nnh12/ROV-Motherboard-2022/Individual Schematics/Daughterboard_Slots_Sch.pdf

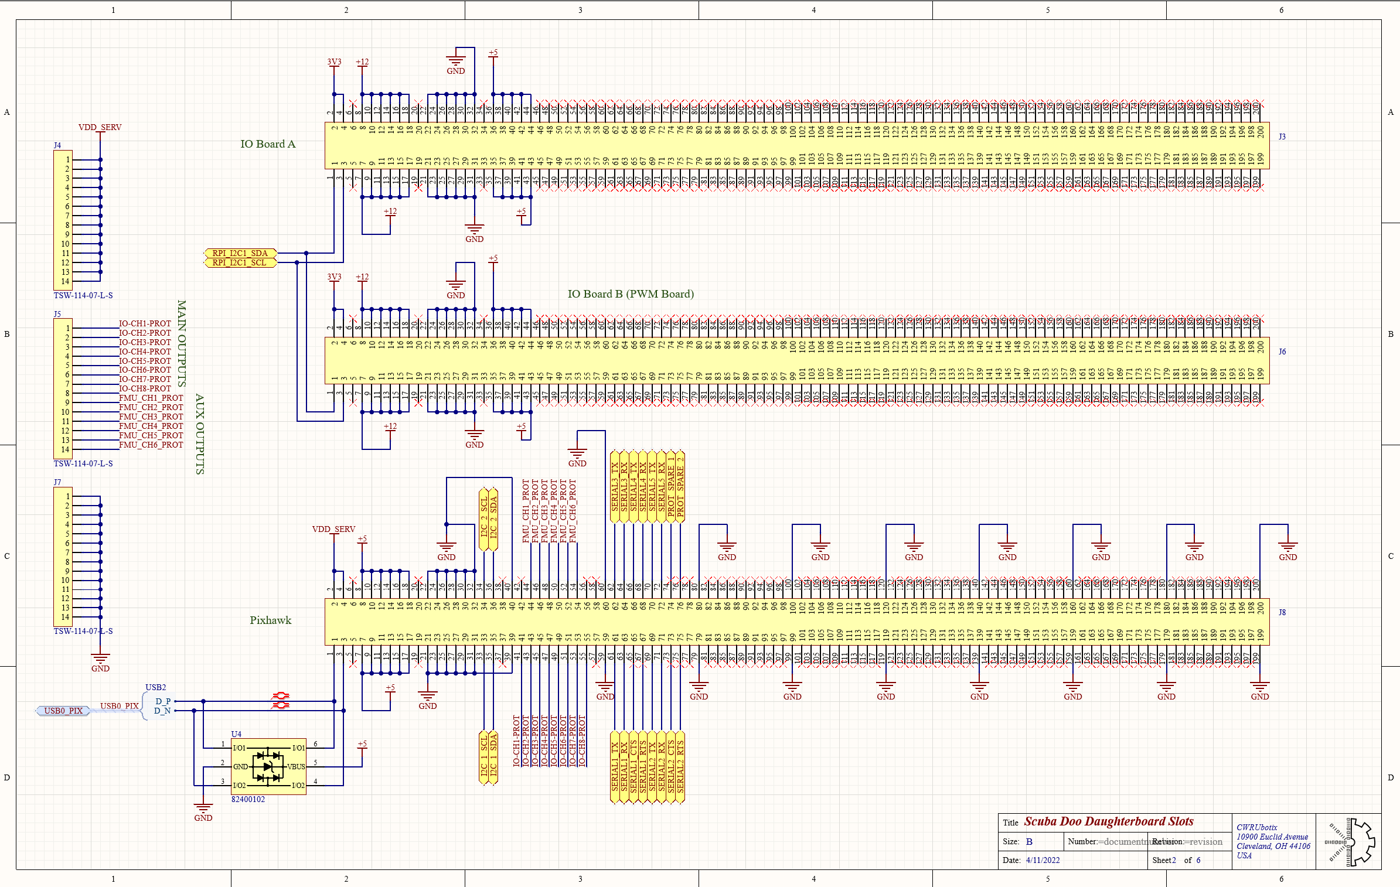
[picture p4: page 1]
