nnh12/ROV-Motherboard-2022/Individual Schematics/Ethernet.pdf

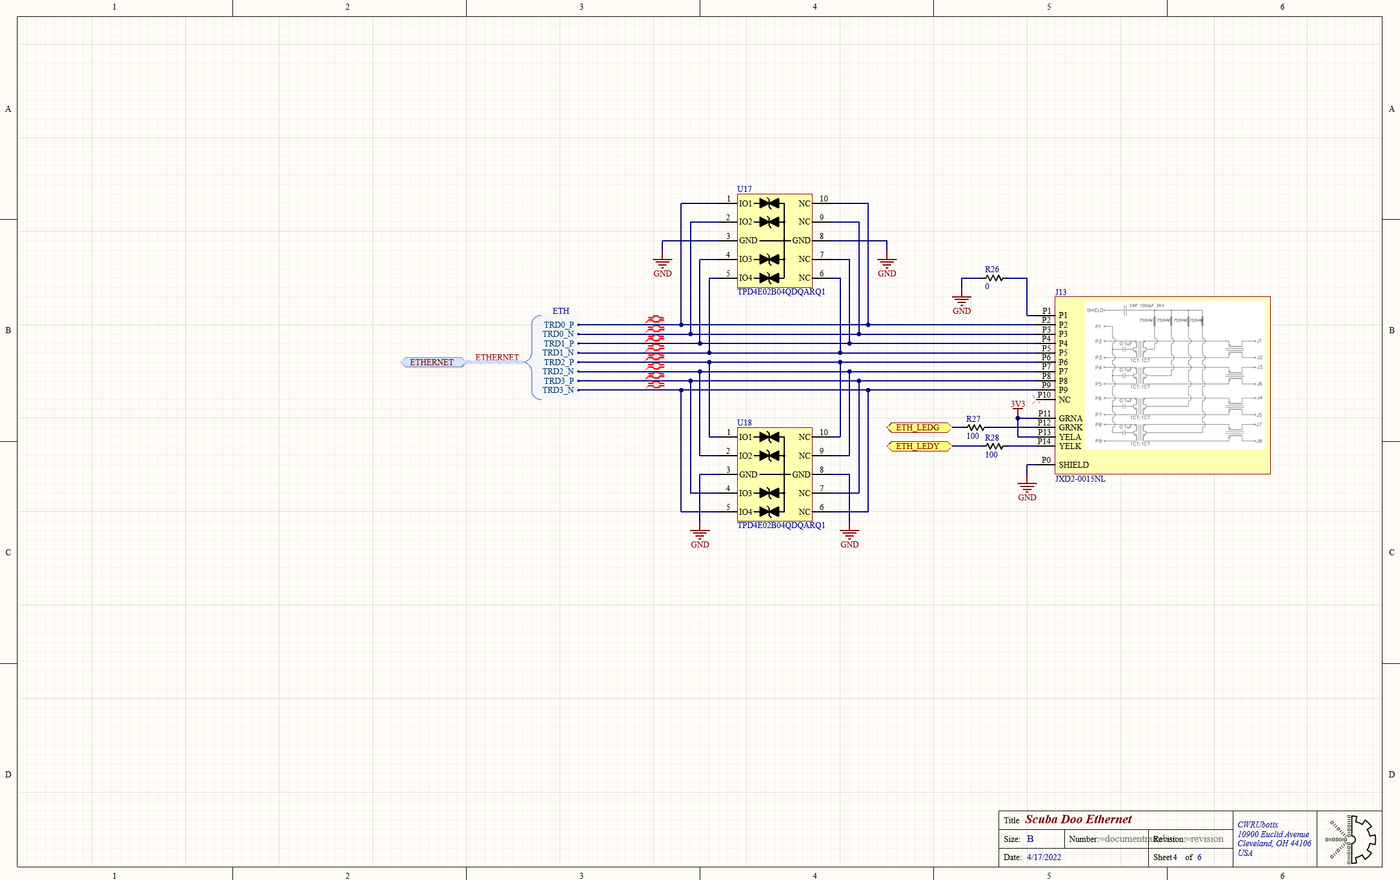
[picture p5: page 1]
