nnh12/ROV-Motherboard-2022/Individual Schematics/Misc_Sch.pdf

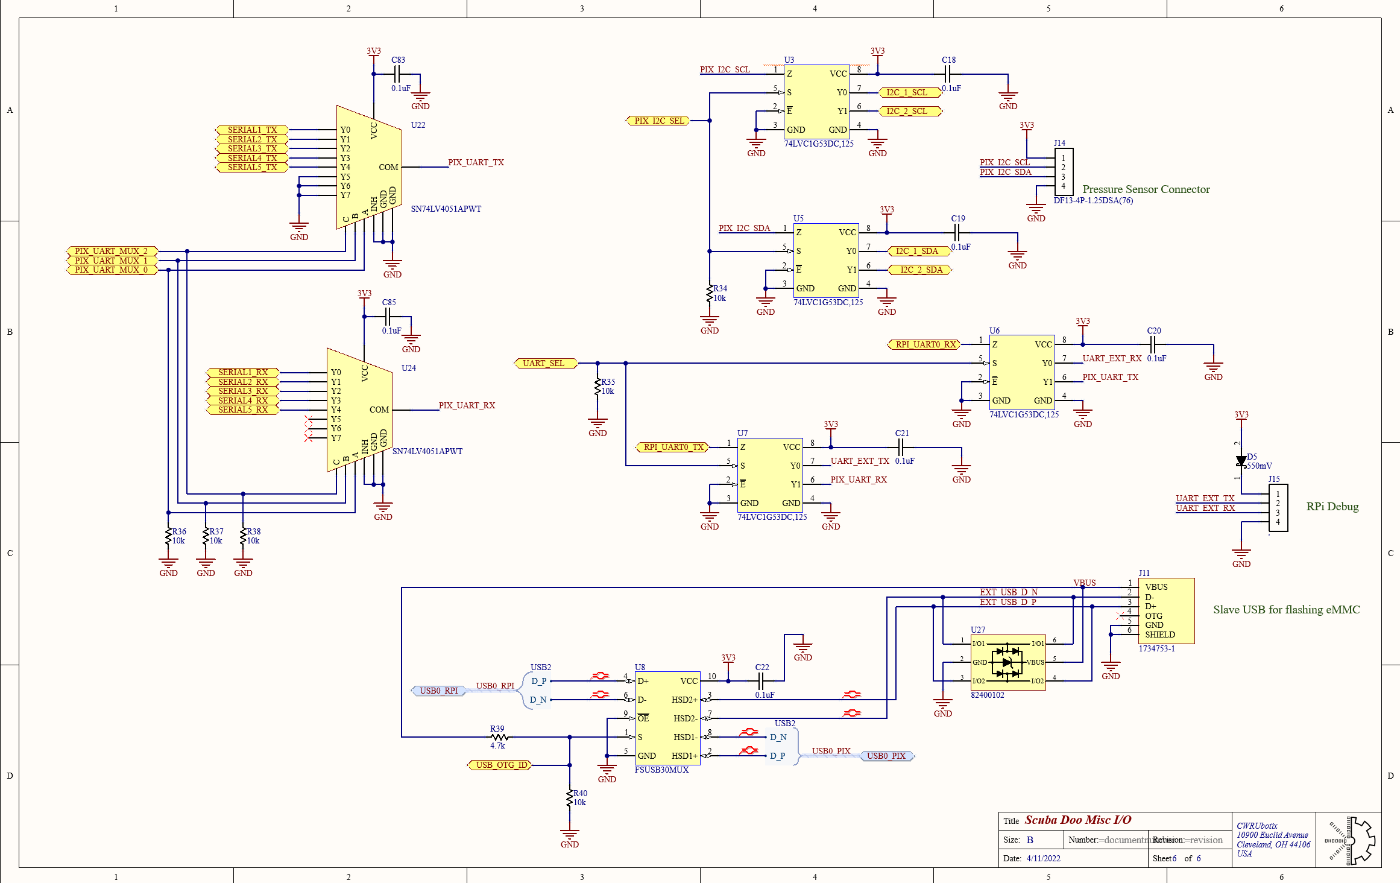
[picture p6: page 1]
