nnh12/ROV-Motherboard-2022/Individual Schematics/PCIe_1x_Sch.pdf

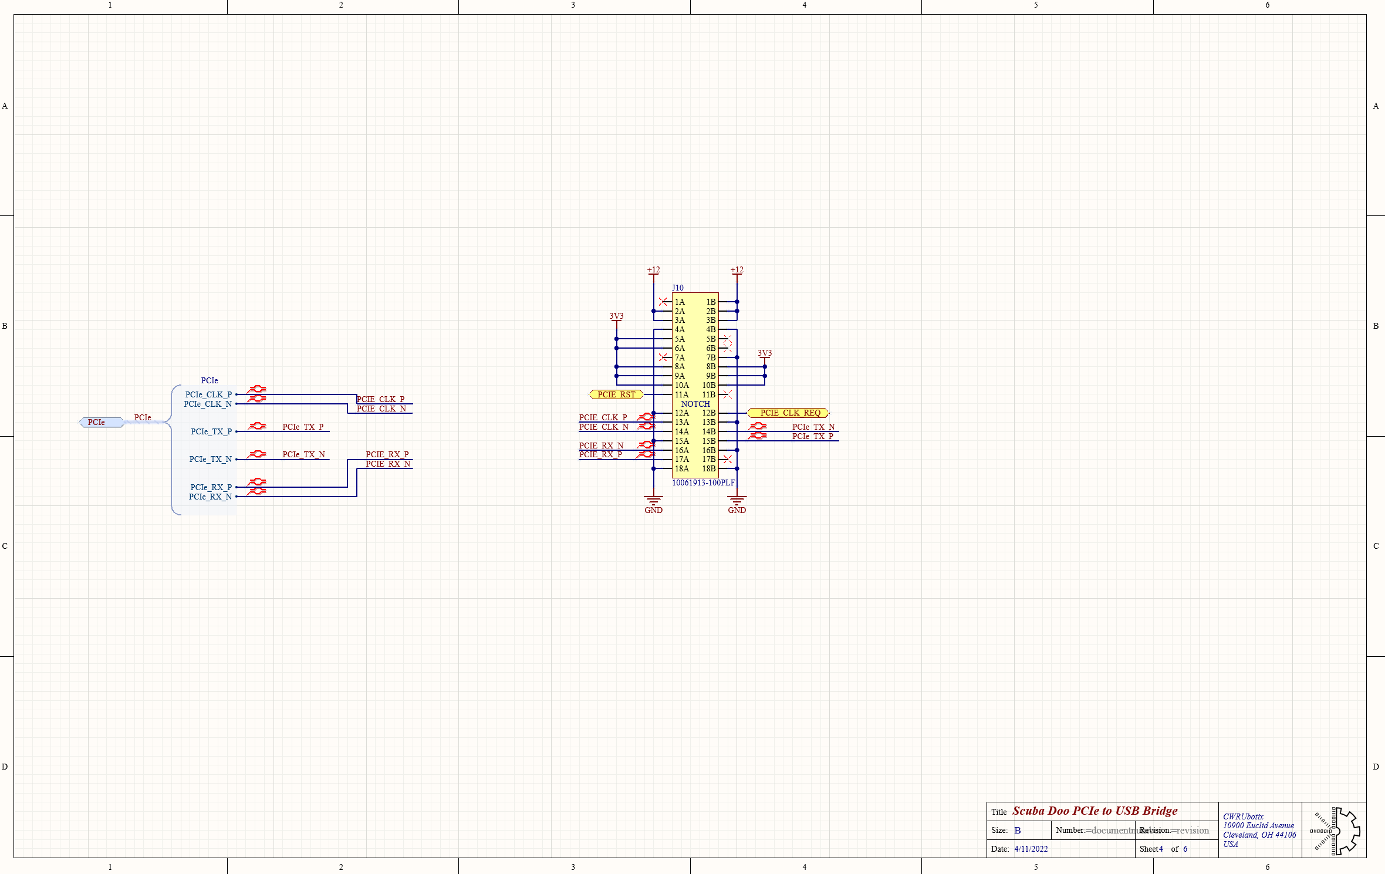
[picture p7: page 1]
