nnh12/ROV-Motherboard-2022/Individual Schematics/Power_Input.pdf

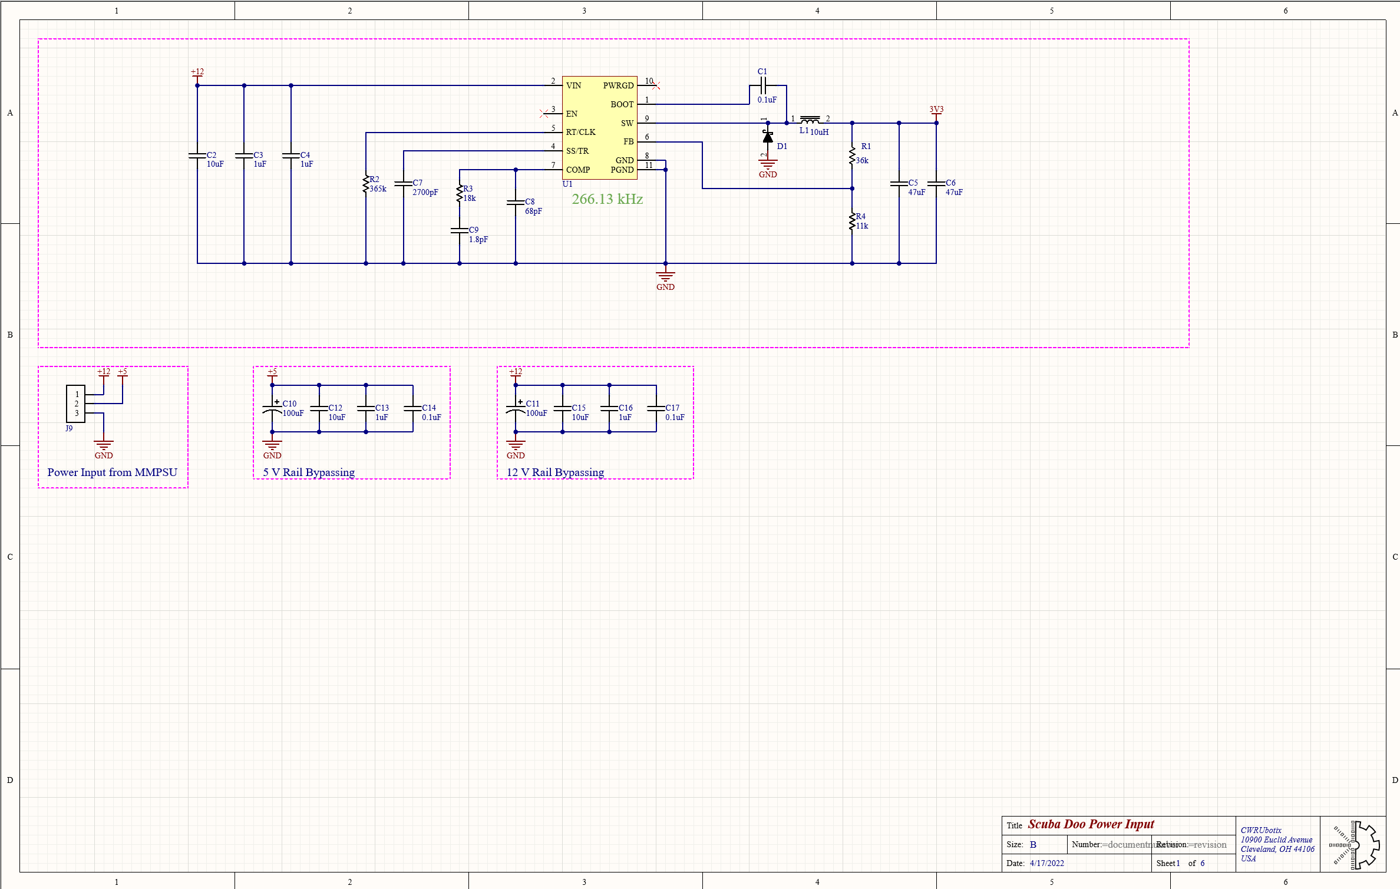
[picture p8: page 1]
