nnh12/ROV-Motherboard-2022/Individual Schematics/RPiCM4_Sch.pdf

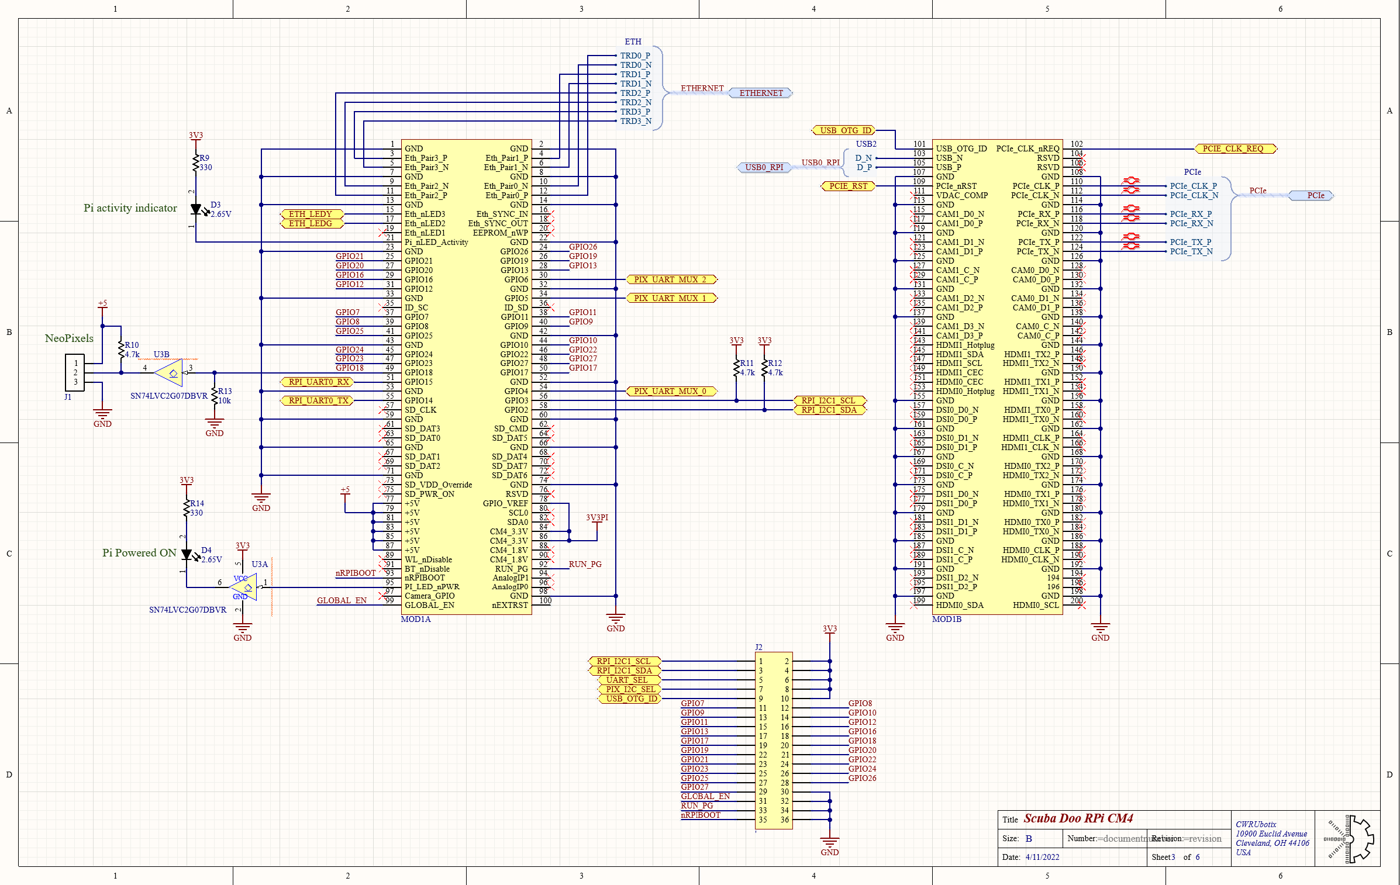
[picture p9: page 1]
