nnh12/ROV-Motherboard-2022/Motherboard_3D_View.pdf

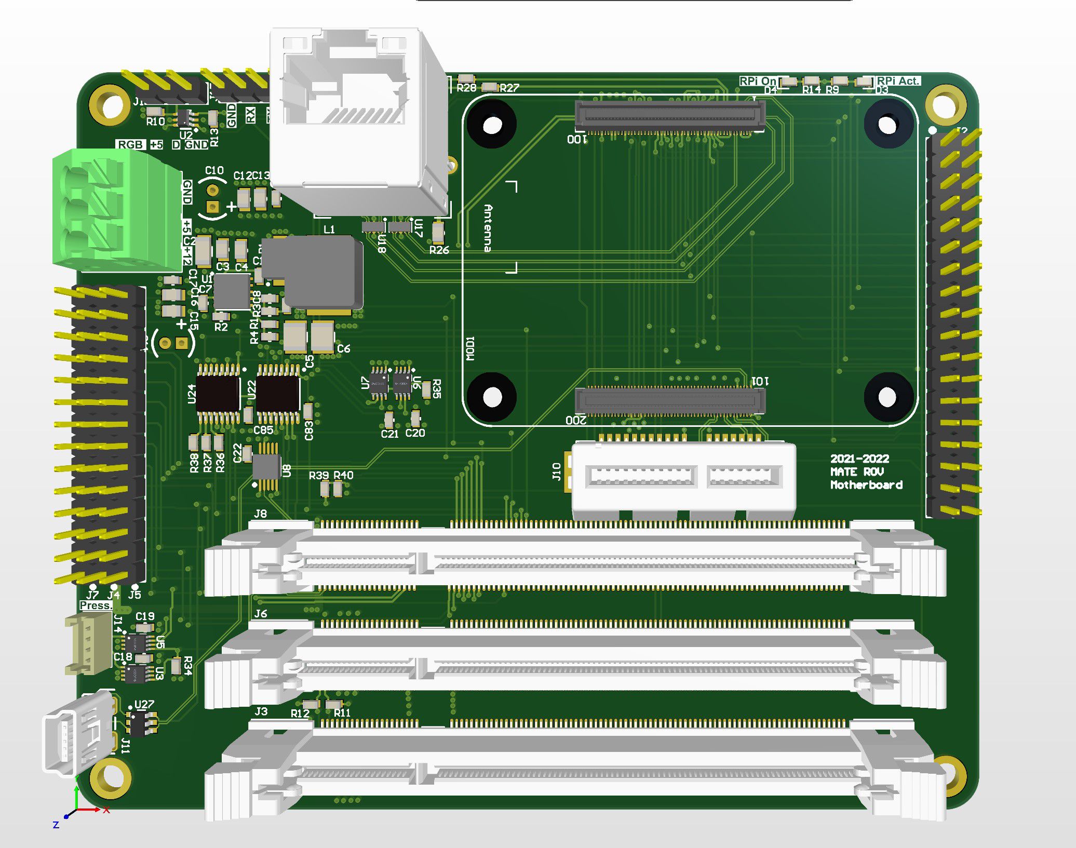
[picture p10: page 1]
