nnh12/ROV-Motherboard-2022/Motherboard_PCB.pdf

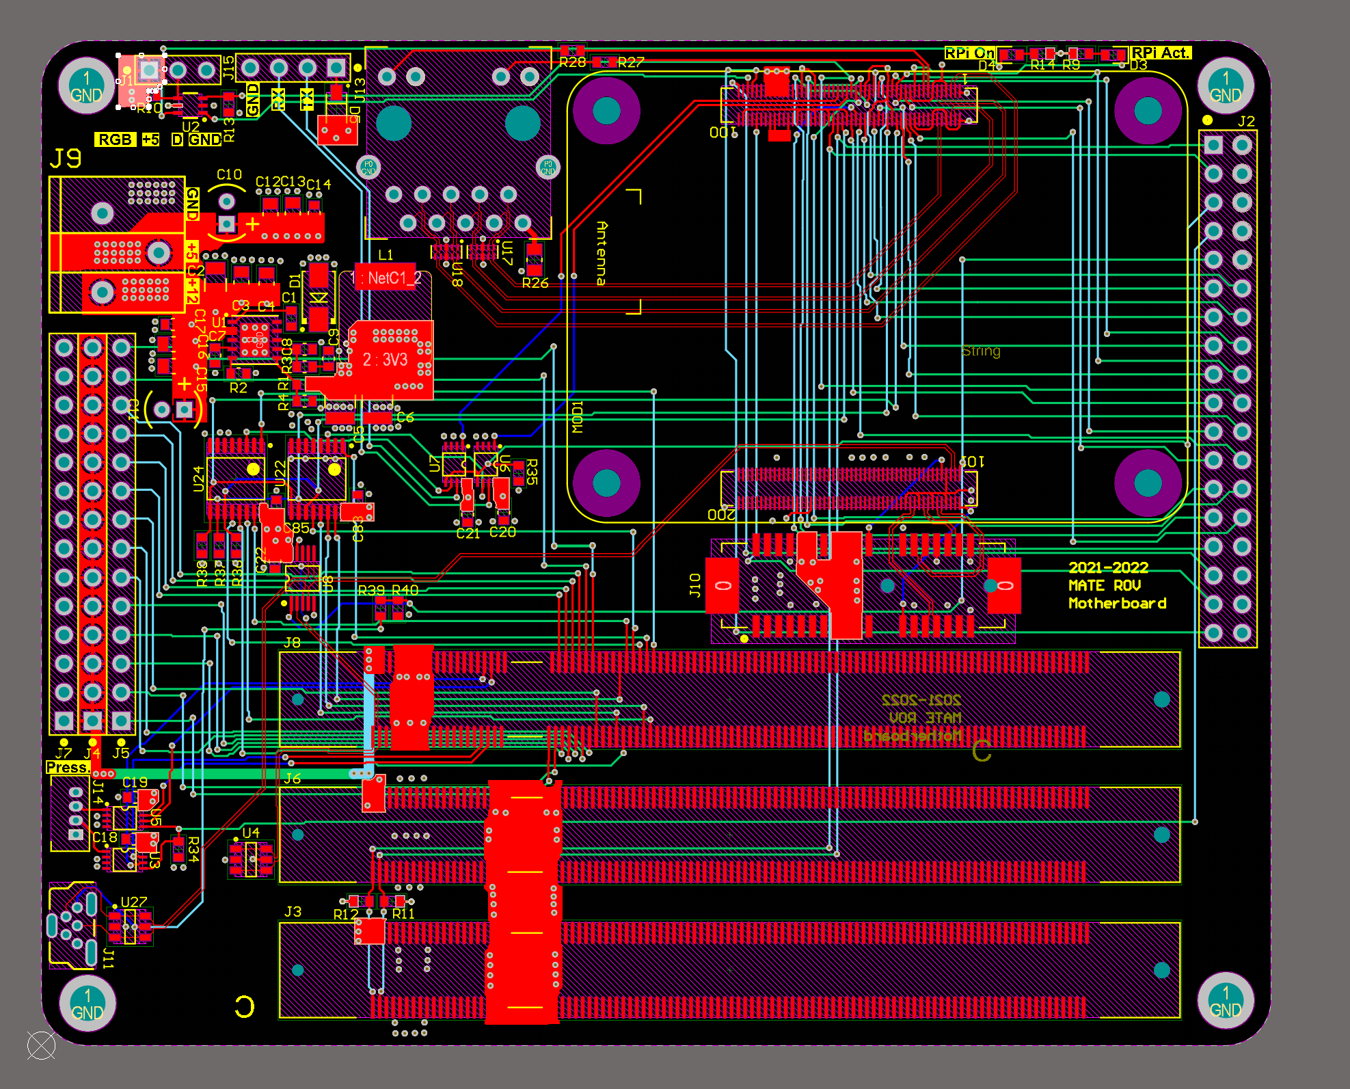
[picture p11: page 1]
