nnh12/ROV-Motherboard-2022/Blocked Diagrams/Motherboard Full Block Diagram.pdf

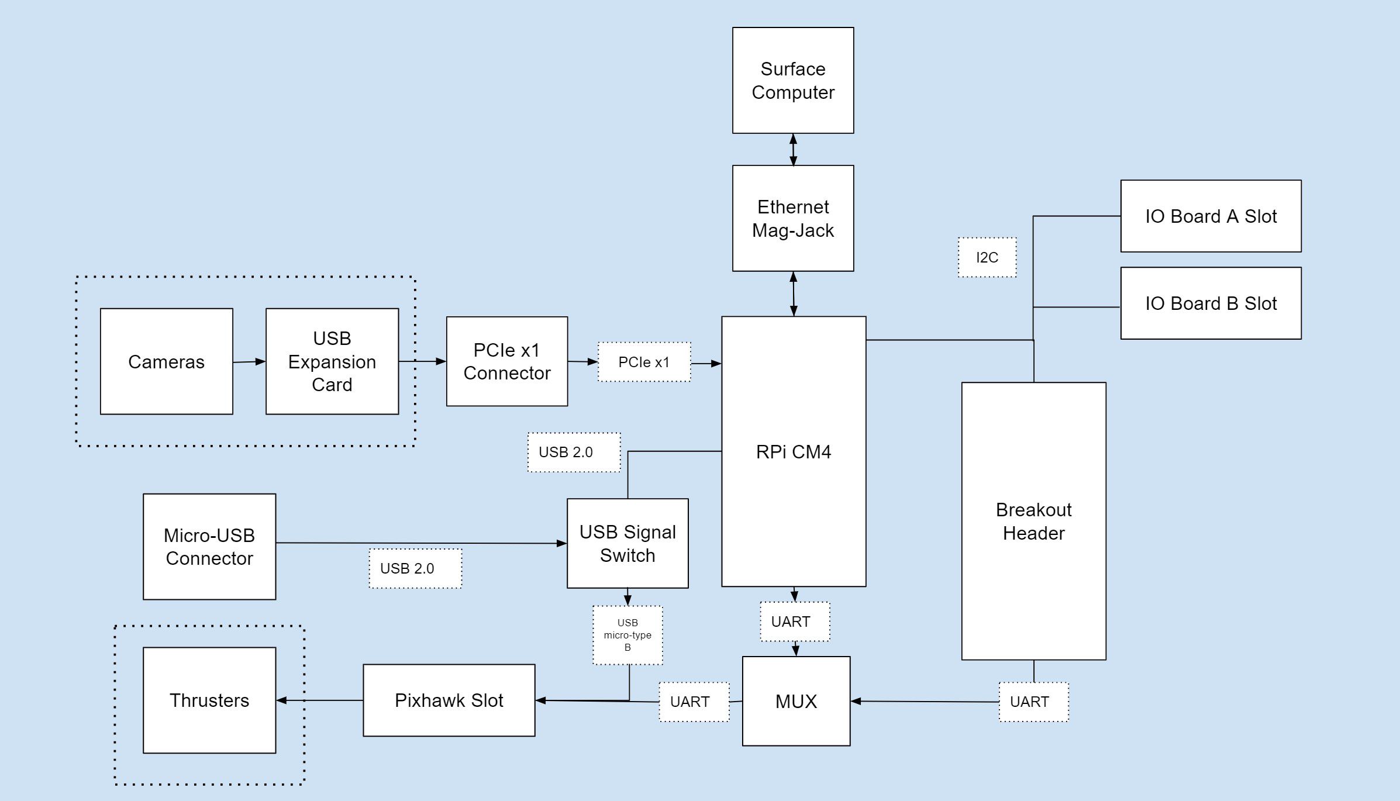
[picture p12: page 1]
