nnh12/ROV-Motherboard-2022/Blocked Diagrams/Images/Motherboard Camera.jpg

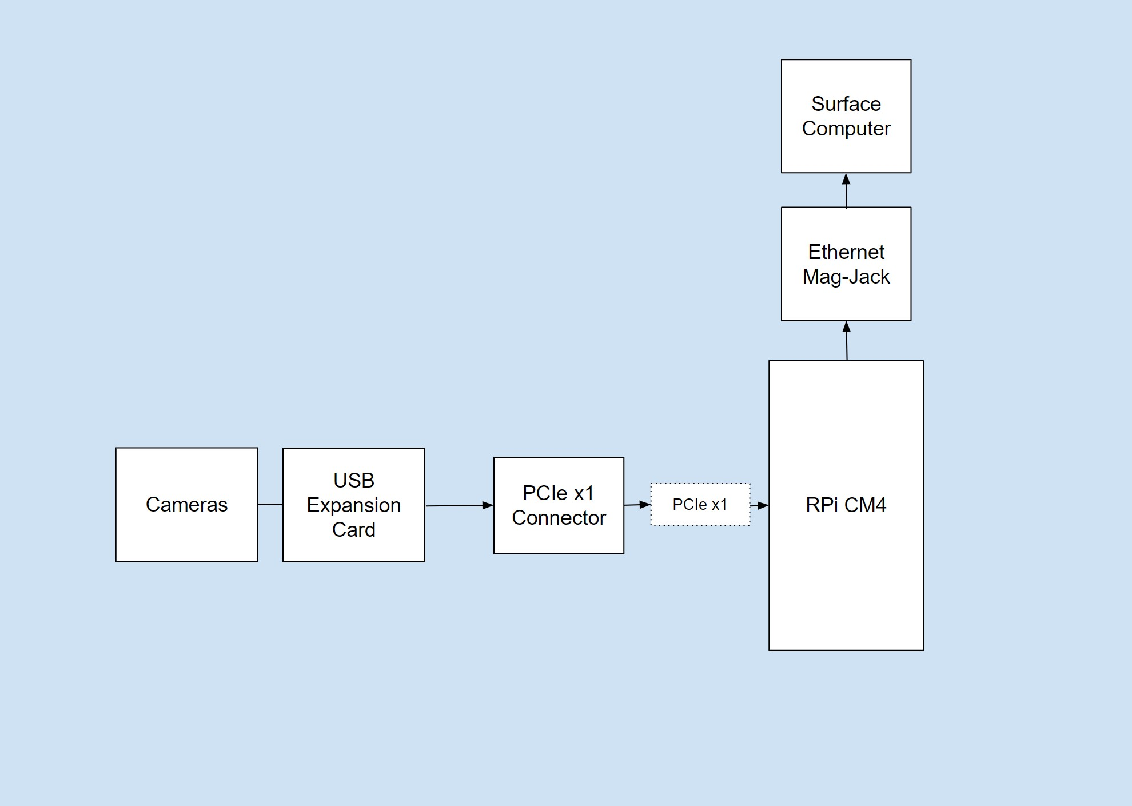
Blocked Diagrams/Images/Motherboard Camera.jpg
