nnh12/ROV-Motherboard-2022/Motherboard Altium PCB File/Images/Board Layout.png

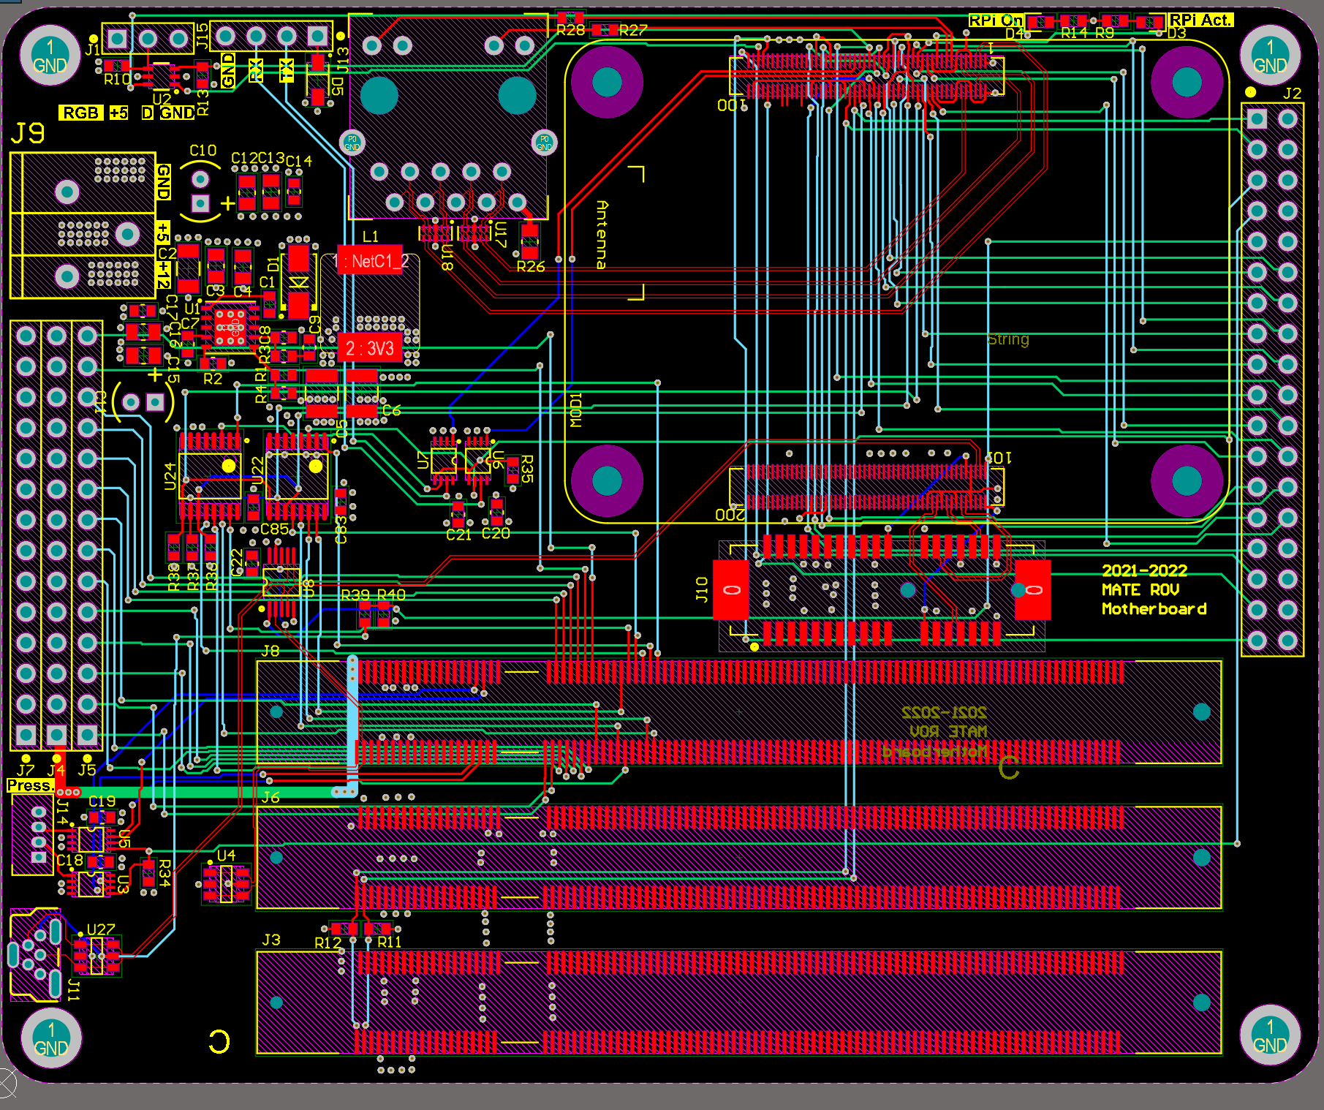
Motherboard Altium PCB File/Images/Board Layout.png
