nnh12/ROV-Motherboard-2022/Motherboard Altium PCB File/Images/Motherboard_PCB_3D_View.png

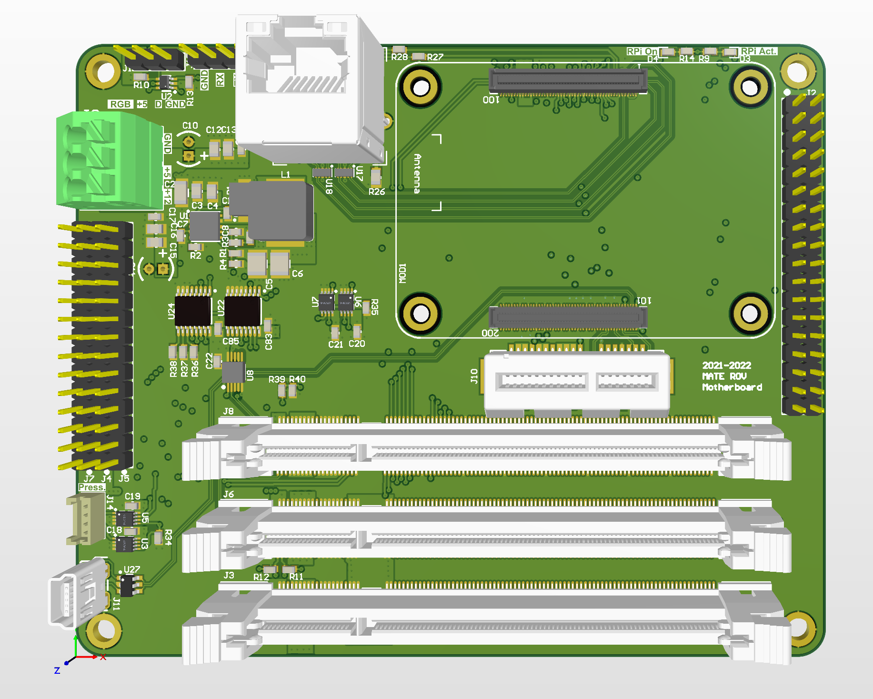
Motherboard Altium PCB File/Images/Motherboard_PCB_3D_View.png
