nnh12/ROV-Motherboard-2022/Motherboard Altium PCB File/Images/Motherboard_PCB_GND _Layer.png

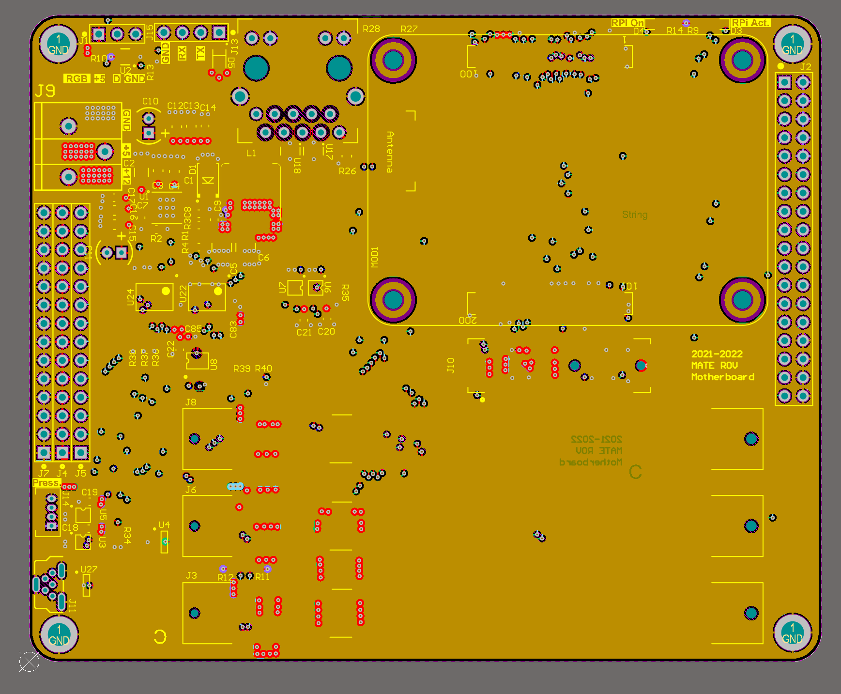
Motherboard Altium PCB File/Images/Motherboard_PCB_GND _Layer.png
