nnh12/ROV-Motherboard-2022/Motherboard Altium PCB File/Images/Motherboard_PCB_Signal_Horizontal_Layer.png

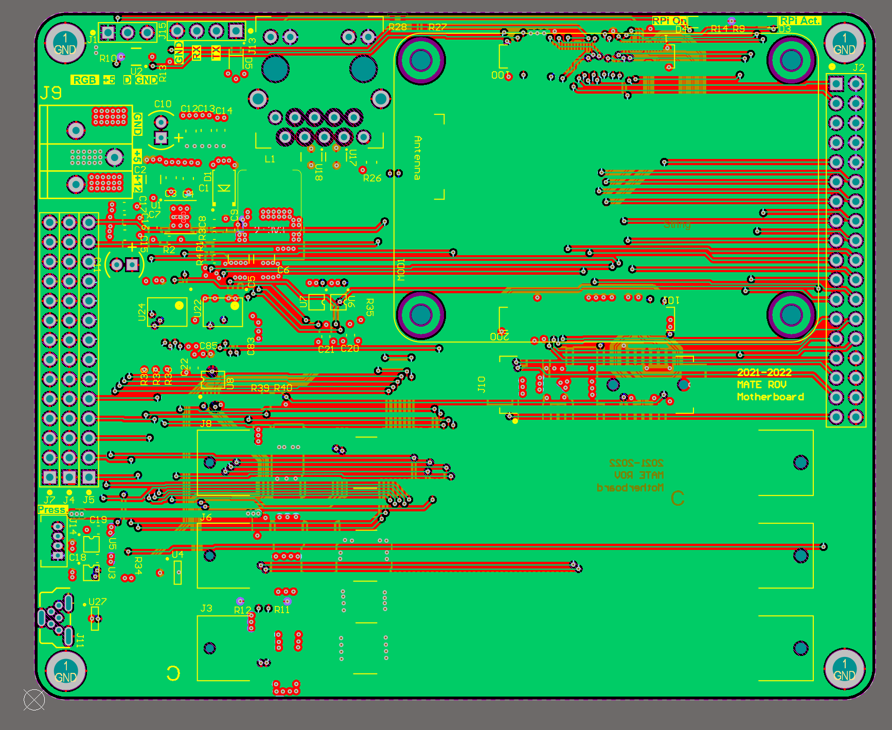
Motherboard Altium PCB File/Images/Motherboard_PCB_Signal_Horizontal_Layer.png
