nnh12/ROV-Motherboard-2022/Motherboard Altium PCB File/Images/Motherboard_PCB_Signal_Vertical_Layer.png

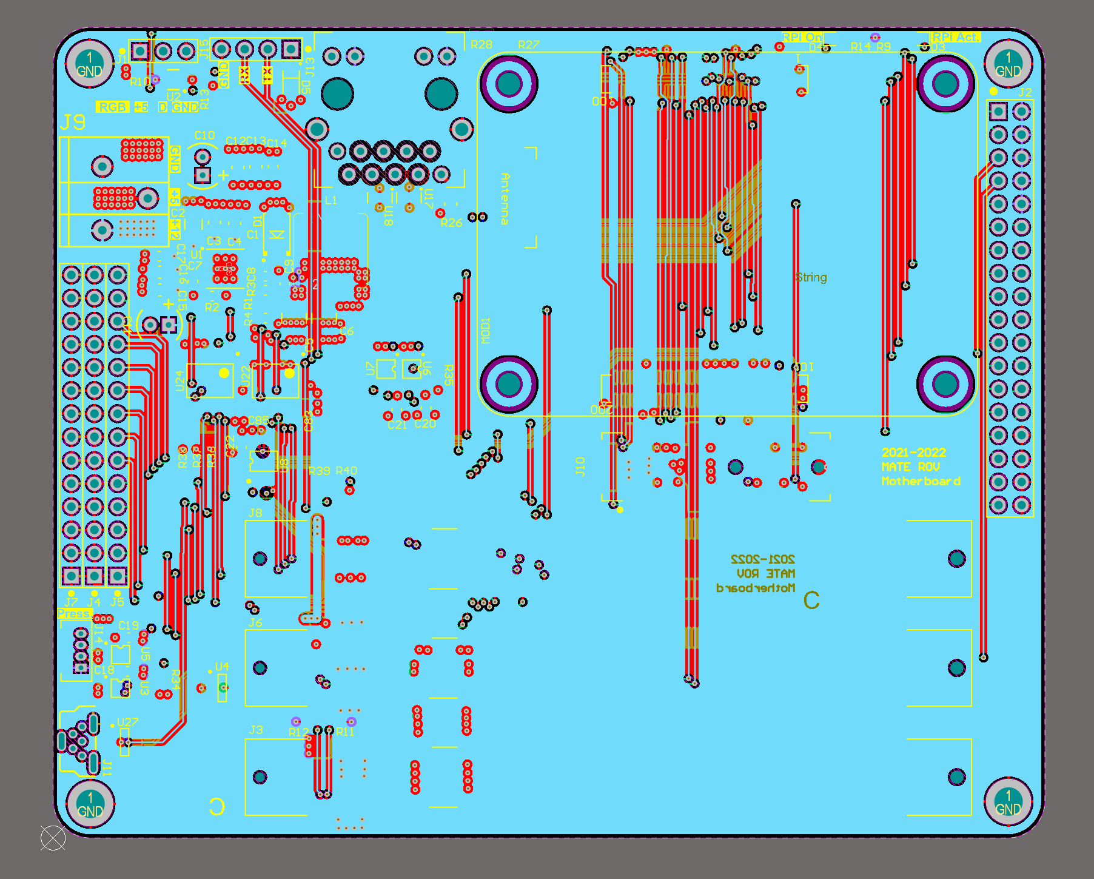
Motherboard Altium PCB File/Images/Motherboard_PCB_Signal_Vertical_Layer.png
