nnh12/ROV-Motherboard-2022/(list of files, drawings)

Other design files:
Motherboard Altium PCB File/MotherBoard_PCB_4 Layers.PrjPcb
Motherboard Altium Schematic Files/DaughterBoard_Slots.SchDoc
Motherboard Altium Schematic Files/Ethernet Con.SchDoc
Motherboard Altium Schematic Files/Misc_IO.SchDoc
Motherboard Altium Schematic Files/PCIe_1x.SchDoc
Motherboard Altium Schematic Files/Power_Input.SchDoc
Motherboard Altium Schematic Files/RPICM4.SchDoc
